andykarpov/karabas-mini-pcb/shield/v2/karabas-mini-shield.stl

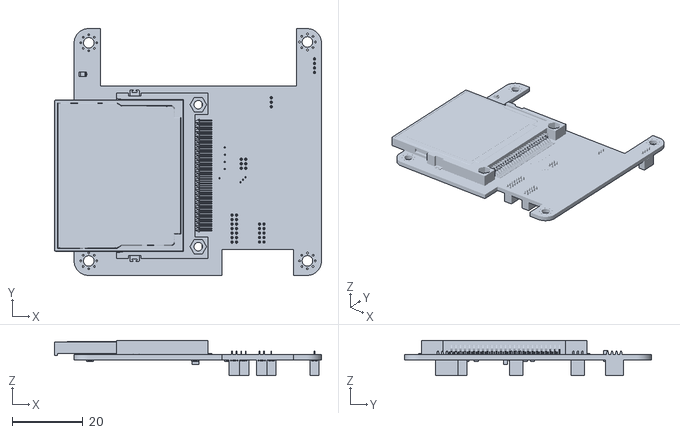
[picture p1: CAD file, 2026-05-14, an earlier design]
shield/v2/karabas-mini-shield.stl
75.5 x 69.8 x 10.00
