andykarpov/karabas-mini-pcb/Errata-revG2_rus.txt

Ошибки revG2:

1) Вывод 19 (~CS) SDRAM U11 разведён на вывод T3 FPGA U7 (цепь ~{SDR_CS}). На предыдущих ревизиях T3 - это
~{CONF_CS}, а ~CS SDRAM на FPGA не заведён, поэтому ядра считают T3 выбором flash и держат его в единице
(FLASH_CS_N = 1): SDRAM никогда не выбирается, и все ядра, которые её используют, не работают. T3 как ~CS
SDRAM управляет только karabas-go-core-sdram-test.

Подтяжки на цепи нет, дорожка идёт только по верхнему слою, без переходных отверстий.

Найдено по схеме и файлам платы. Подтверждено на плате revG2: резистор 1k от вывода 19 U11 на GND
исправил SDRAM (issue #2, фото: https://github.com/andykarpov/karabas-go/blob/master/docs/mini/revG2_mod.md).

Хотфикс: перерезать дорожку ~{SDR_CS} рядом с выводом 19 U11 и подключить вывод 19 к GND через резистор
1к..10к или перемычкой. Одного резистора на землю без реза недостаточно: выход FPGA удержит единицу.

Программное исправление (нужна пересборка каждого ядра): выводить 0 на T3 в топах Mini G (FLASH_CS_N = 0).
Это безопасно и на revG: посадочное место конфигурационной flash не запаивается, и ядра её не используют.
Вместе с хотфиксом не требуется.

В следующей ревизии: подключить вывод 19 U11 к GND.
