andykarpov/karabas-mini-pcb/karabas-mini-revG2.pdf

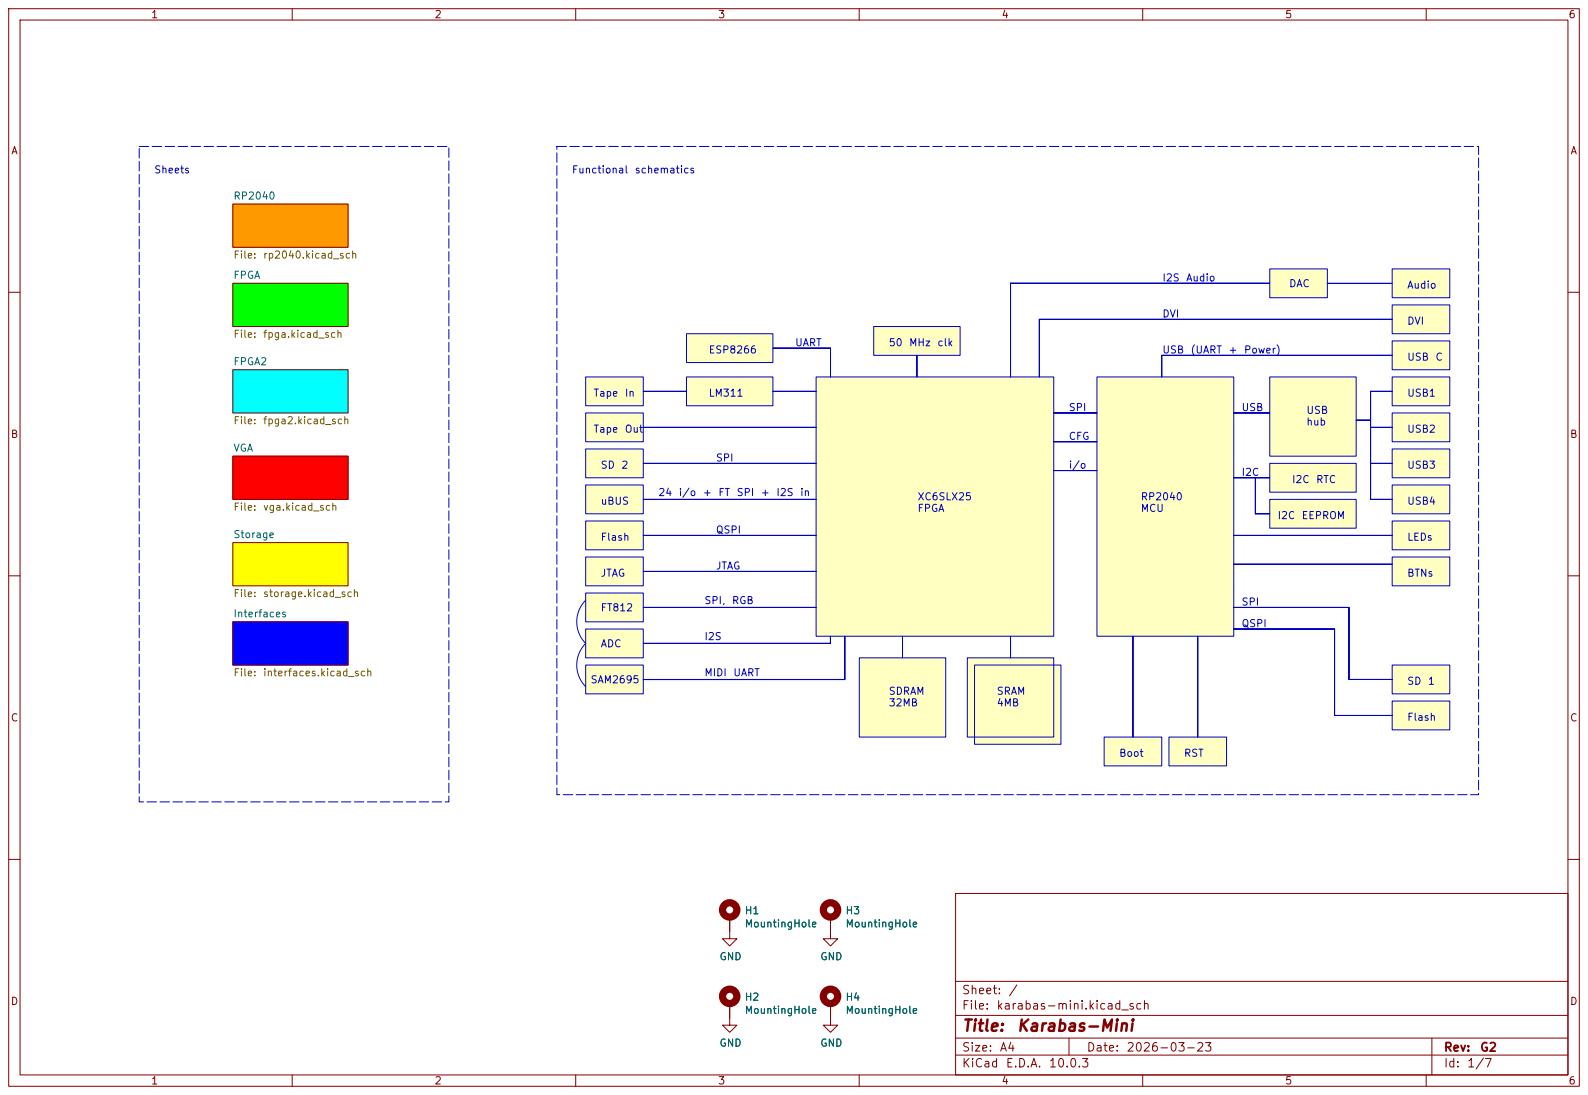
[picture p2: page 1]

Functional schematics 24 i/o + FT SPI + I2S in

Size: A4 | Rev: G2
KiCad E.D.A. 10.0.3 | Id: 1/7

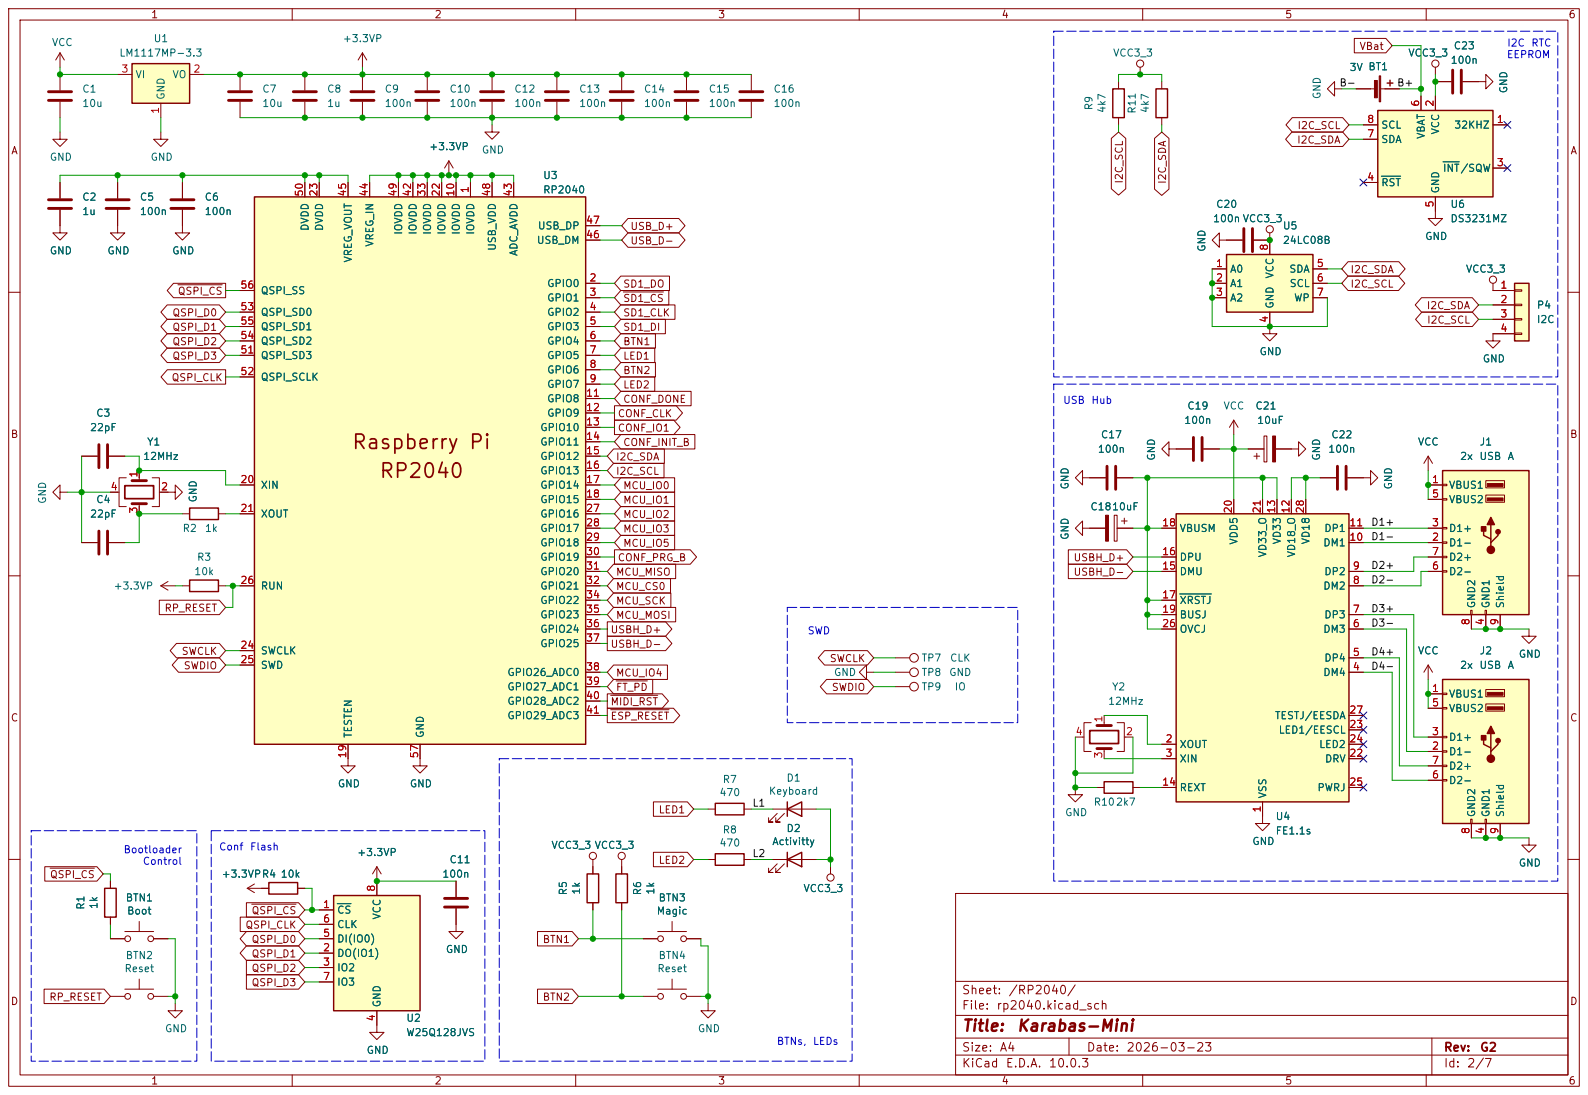
[picture p3: page 2]

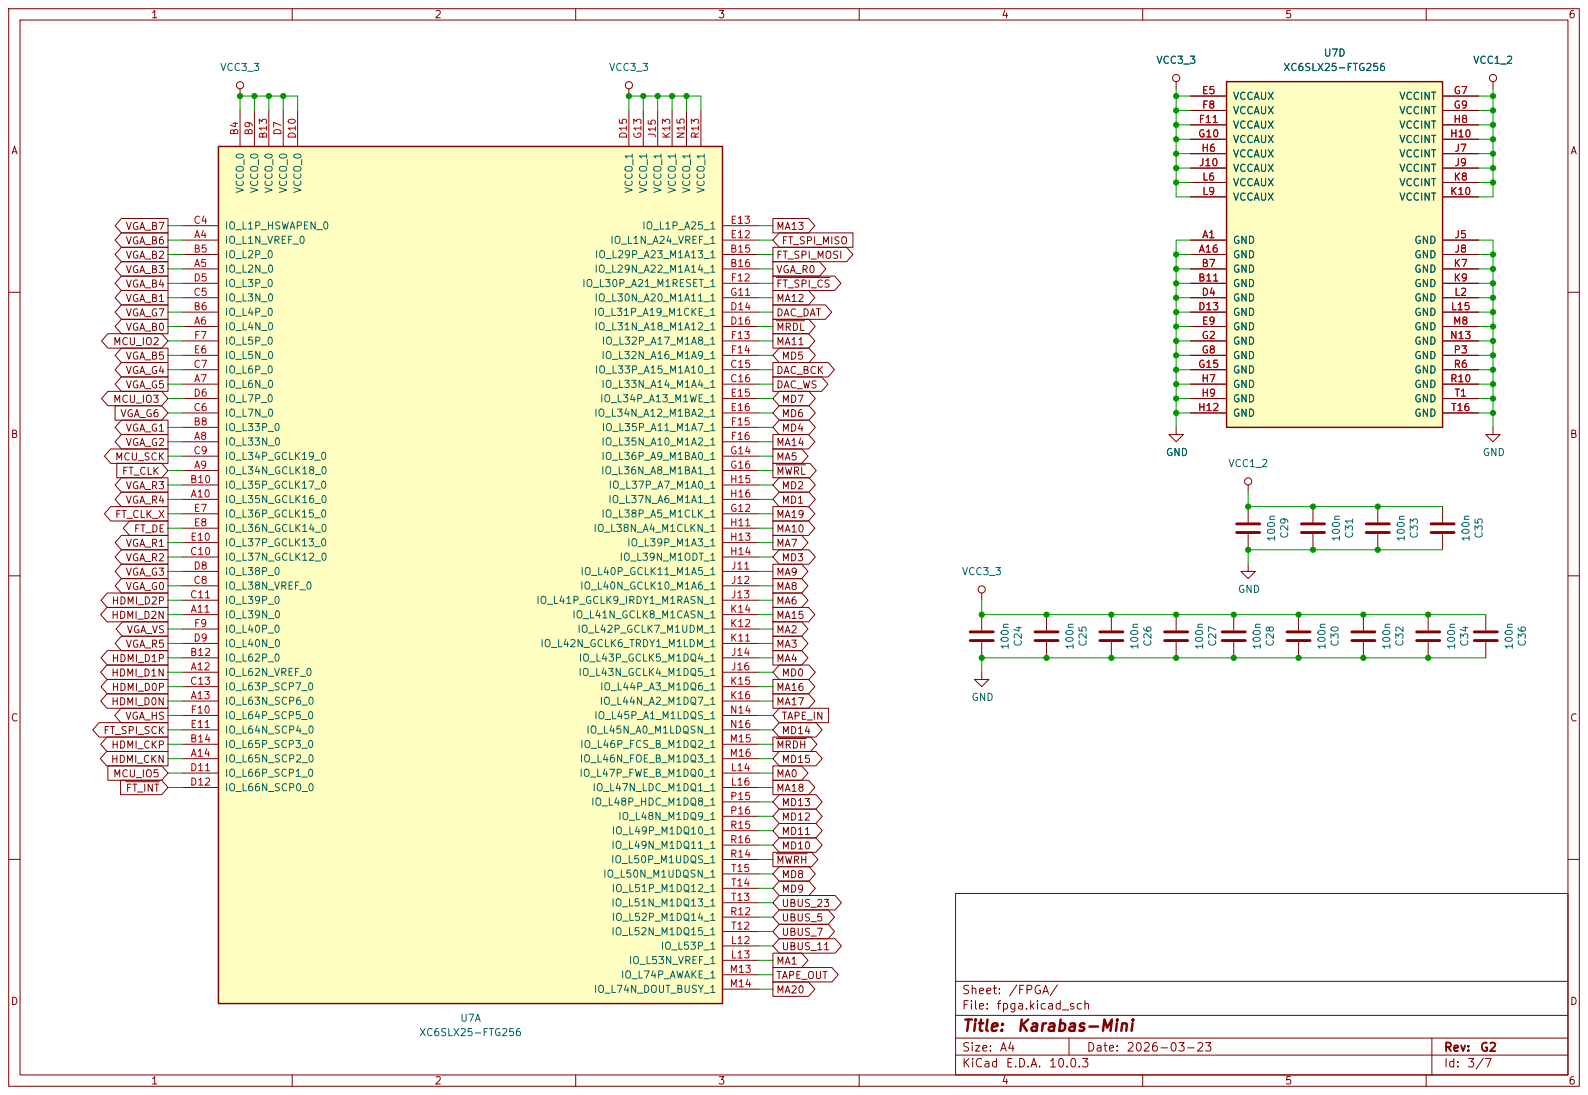
[picture p4: page 3]

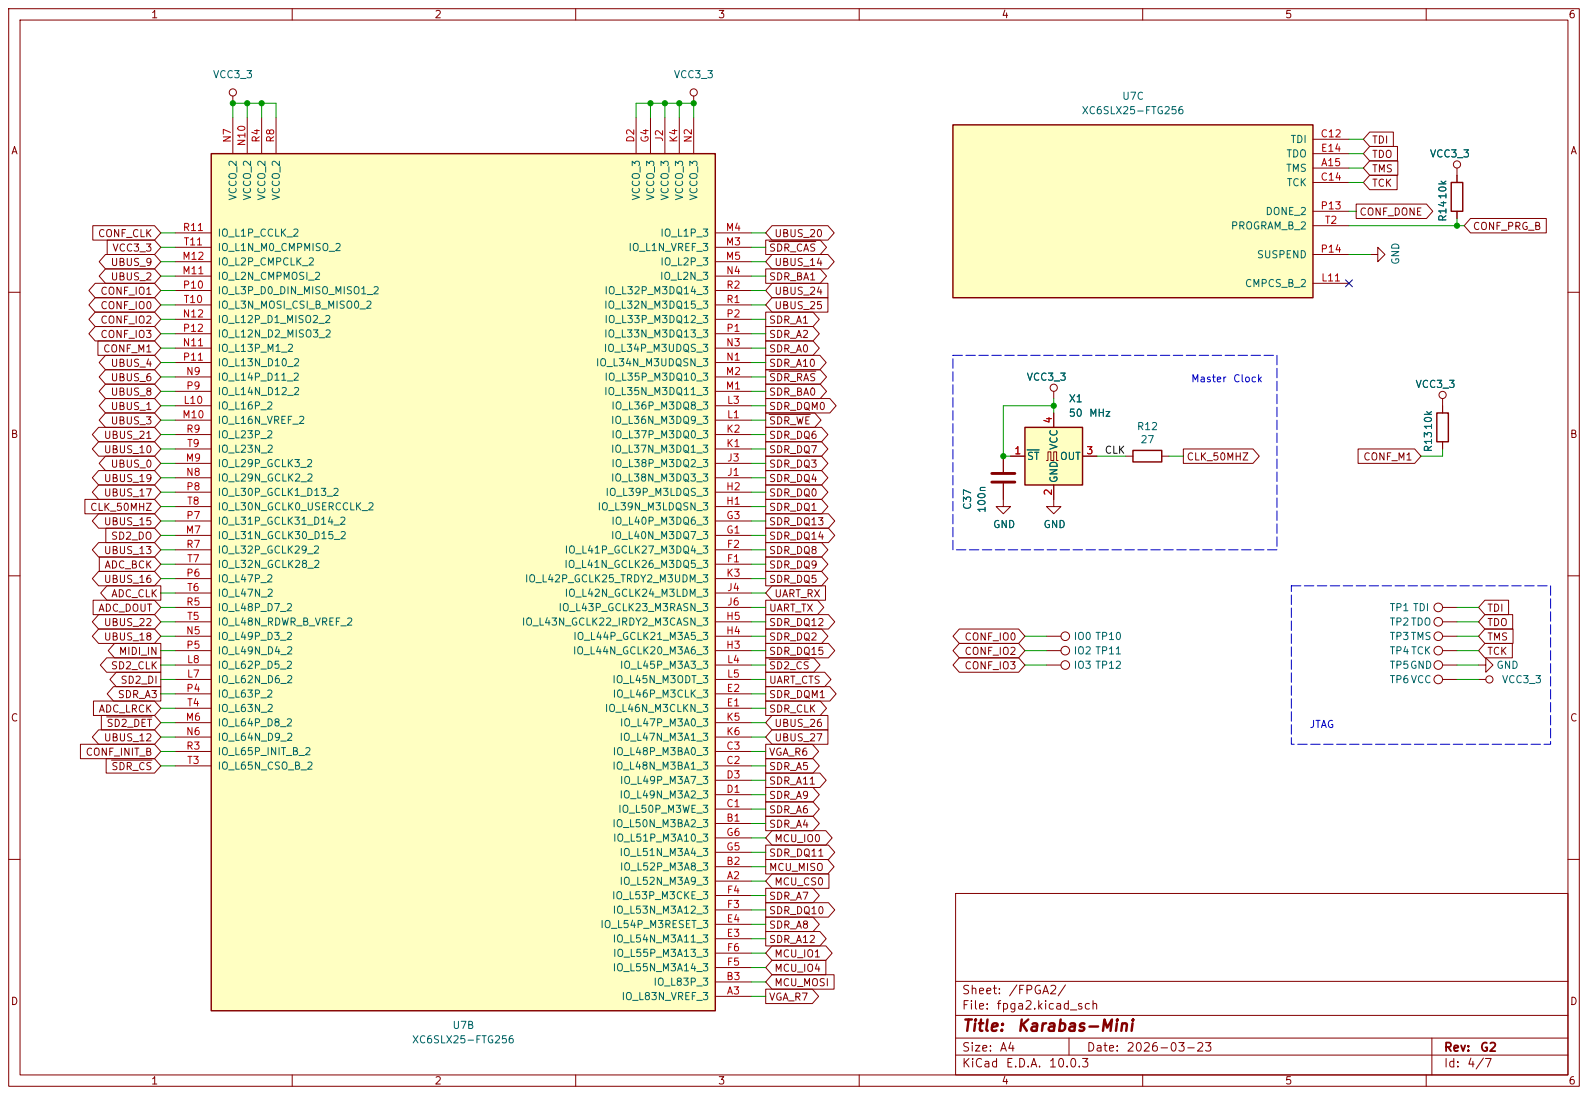
[picture p5: page 4]

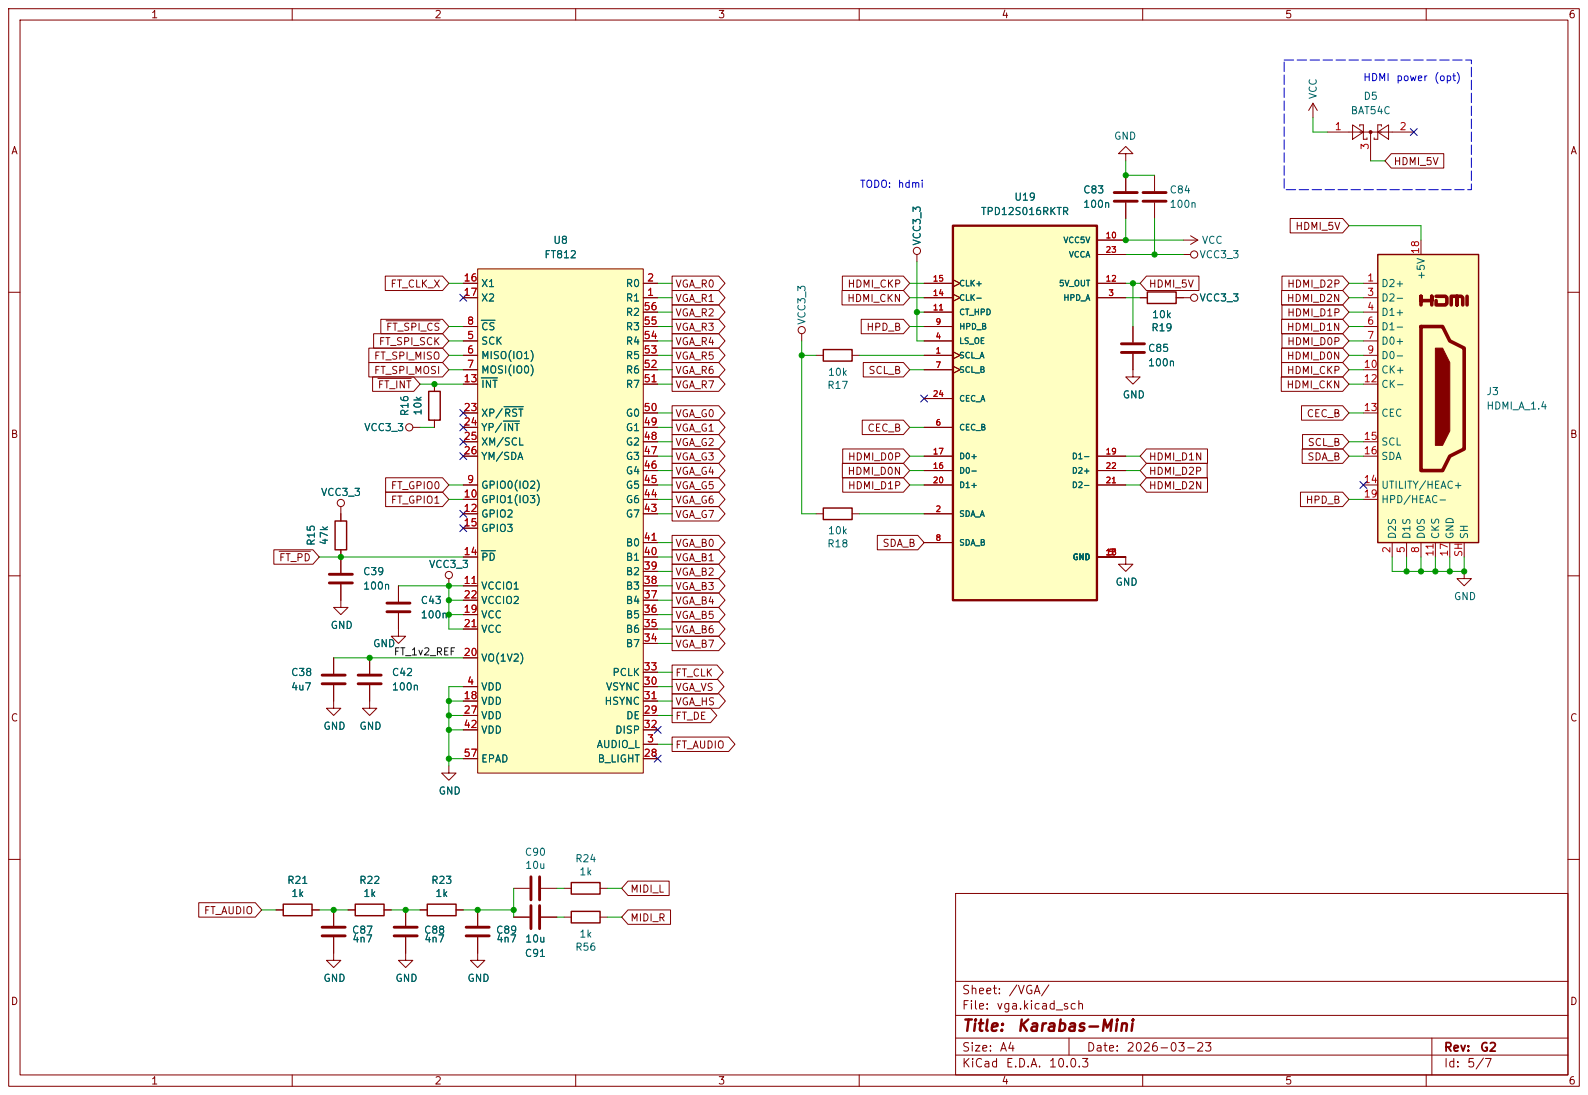
[picture p6: page 5]

XP/RST 23
YP/INT 24
XM/SCL 25
YM/SDA 26
VSYNC 30 HSYNC 31 DISP 32 PCLK 33 B7 34 B6 35 B5 36 B4 37 B3 38 B2 39 B1 40 B0 41

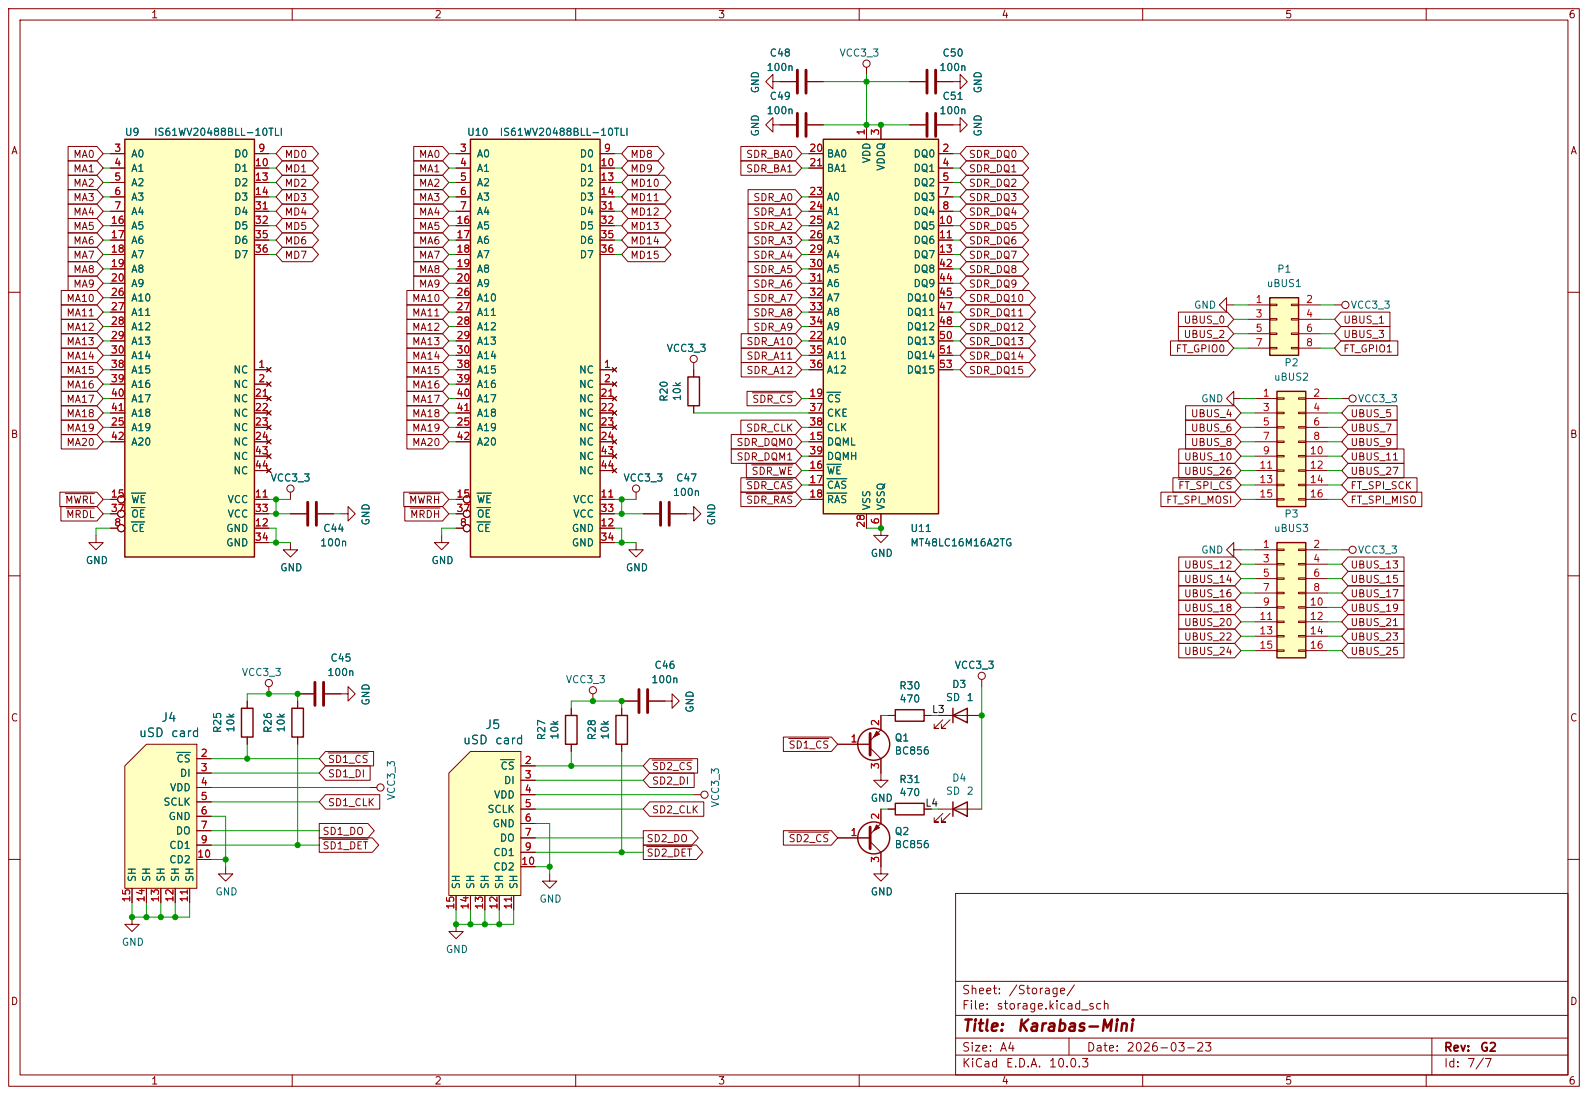
[picture p7: page 6]

6 DQ3 7 DQ4 8 DQ5 10 DQ6 11 DQ7 13 DQML 15 WE 16 CAS 17 RAS 18 CS 19 BA0 20 BA1 21

SCLK 5 GND 6 DO 7 CD1 9 CD2 10 SH 11 SH 12 SH 13 SH 14 SH 15

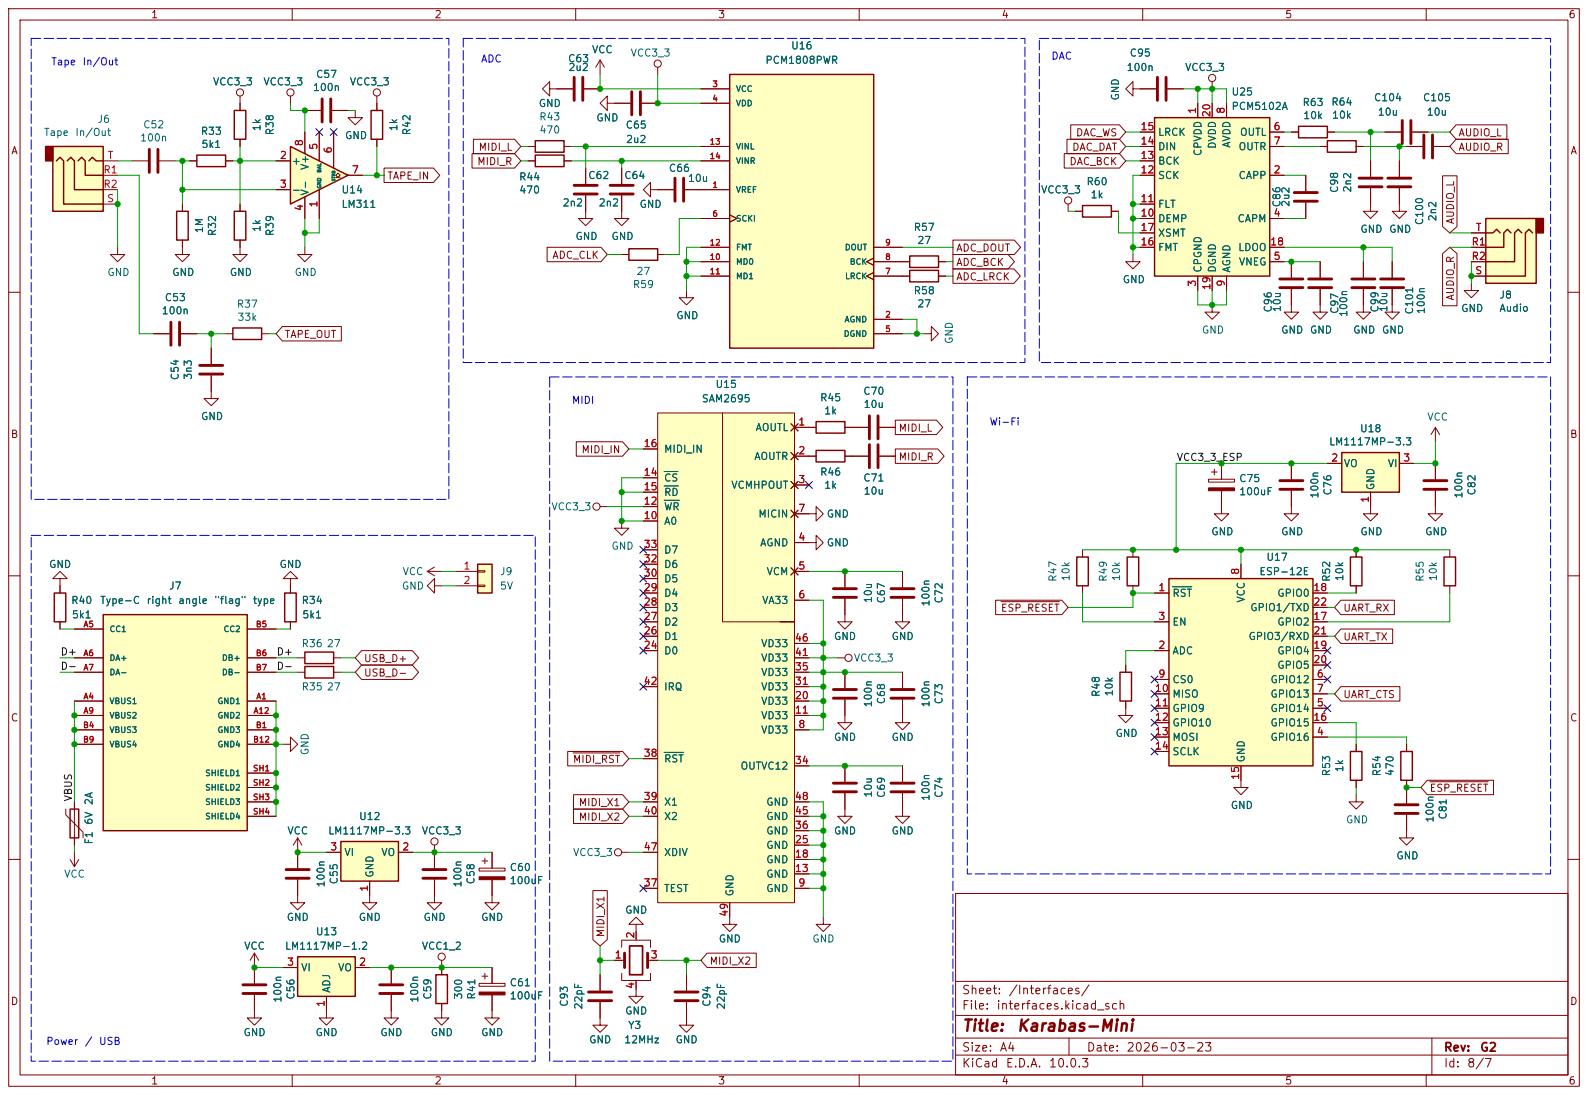
[picture p8: page 7]

10u C98 2n2 GND
SCK 12 BCK 13 DIN 14 LRCK 15

Type-C right angle "flag" type 100n C56 R35 27 R34
Type-C right angle "flag" type
