andykarpov/karabas-mini-pcb/karabas-mini-revC.pdf

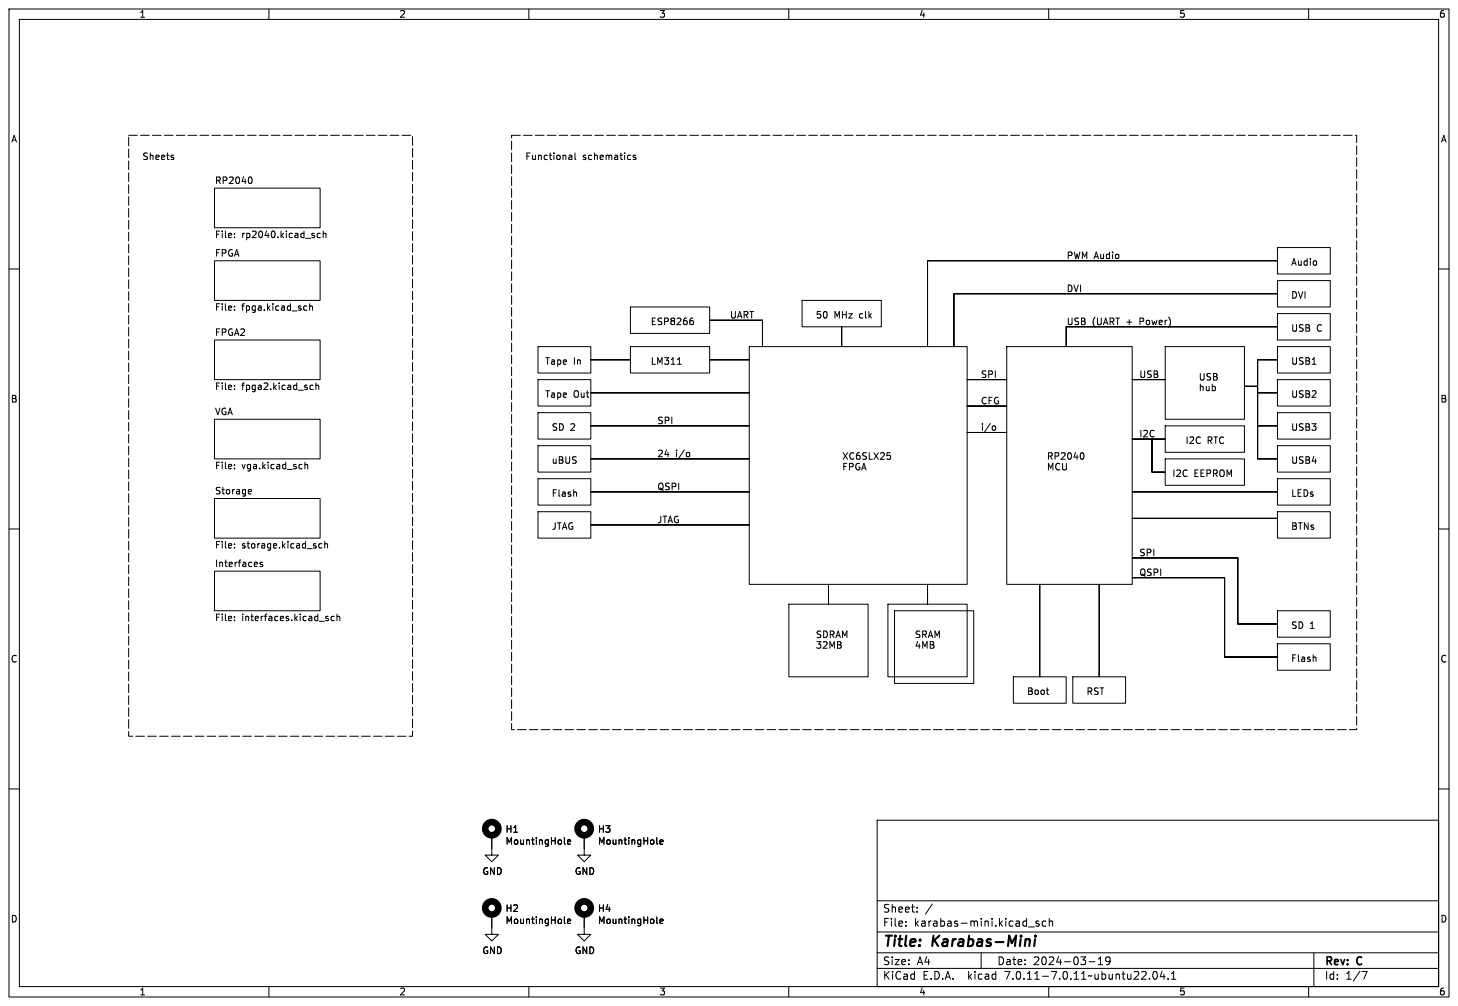
[picture p23: page 1]

File: fpga.kicad_sch RP2040 File: rp2040.kicad_sch VGA
Interfaces File: interfaces.kicad_sch FPGA

Id: 1/7 Title: Karabas-Mini File: karabas-mini.kicad_sch Sheet: /

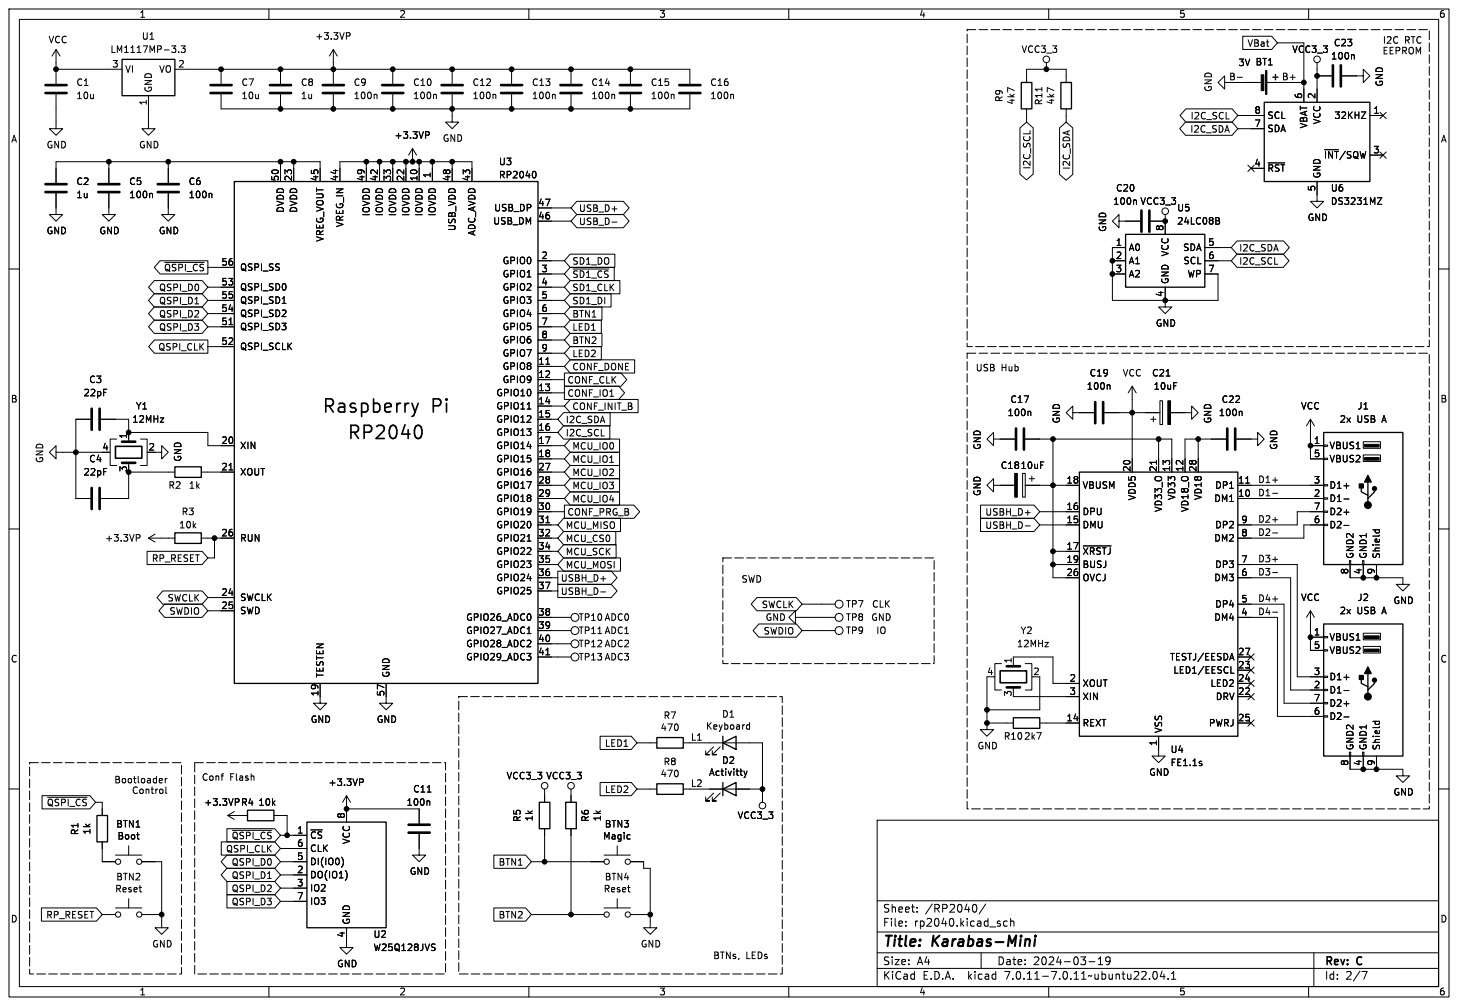
[picture p24: page 2]

6 SDA 7 SCL 8 U6 DS3231MZ GND GND GND GND

6 SDA 7 SCL 8 GND GND

1 IOVDD 10 GPIO8 11 GPIO9 12 GPIO10 13 GPIO11 14 GPIO12 15 GPIO13 16 GPIO14 17 GPIO15 18 TESTEN 19 GPIO0 2 XIN 20 XOUT 21 IOVDD 22 DVDD 23 SWCLK 24 SWD 25 RUN 26 GPIO16 27 GPIO17 28 GPIO18 29 GPIO1 3 GPIO19 30 GPIO20 31 GPIO21 32 IOVDD 33 GPIO22 34 GPIO23 35 GPIO24 36 GPIO25 37 GPIO26_ADC0 38 GPIO27_ADC1 39 GPIO2 4 GPIO28_ADC2 40 GPIO29_ADC3 41 IOVDD 42 ADC_AVDD 43 VREG_IN 44 VREG_VOUT 45 USB_DM 46 USB_DP 47 USB_VDD 48 IOVDD 49 GPIO3 5 DVDD 50 QSPI_SD3 51 QSPI_SCLK 52 QSPI_SD0 53 QSPI_SD2 54 QSPI_SD1 55 QSPI_SS 56 GND 57 GPIO4 6 GPIO5 7 GPIO6 8 GPIO7 9 U3 RP2040 TP10 ADC0 GND
VCC3_3 GND

1 IOVDD 10 GPIO8 11 GPIO9 12 GPIO10 13 GPIO11 14 GPIO12 15 GPIO13 16 GPIO14 17 GPIO15 18 TESTEN 19 GPIO0 2 XIN 20 XOUT 21 IOVDD 22 DVDD 23 SWCLK 24 SWD 25 RUN 26 GPIO16 27 GPIO17 28 GPIO18 29 GPIO1 3 GPIO19 30 GPIO20 31 GPIO21 32 IOVDD 33 GPIO22 34 GPIO23 35 GPIO24 36 GPIO25 37 GPIO26_ADC0 38 GPIO27_ADC1 39 GPIO2 4 GPIO28_ADC2 40 GPIO29_ADC3 41 IOVDD 42 ADC_AVDD 43 VREG_IN 44 VREG_VOUT 45 USB_DM 46 USB_DP 47 USB_VDD 48 IOVDD 49 GPIO3 5 DVDD 50 QSPI_SD3 51 QSPI_SCLK 52 QSPI_SD0 53 QSPI_SD2 54 QSPI_SD1 55 QSPI_SS 56 GND 57 GPIO4 6 GPIO5 7 GPIO6 8 GPIO7 9 GND

4 SDA 5 SCL 6 WP 7 VCC

1 DM1 10 DP1 11 VD18_O 12 VD33 13 REXT 14 DMU 15 DPU 16 ~{XRSTJ} 17 VBUSM 18 BUSJ 19 XOUT 2 VDD5 20 VD33_O 21 DRV 22

Id: 2/7 Title: Karabas-Mini File: rp2040.kicad_sch Sheet: /RP2040/

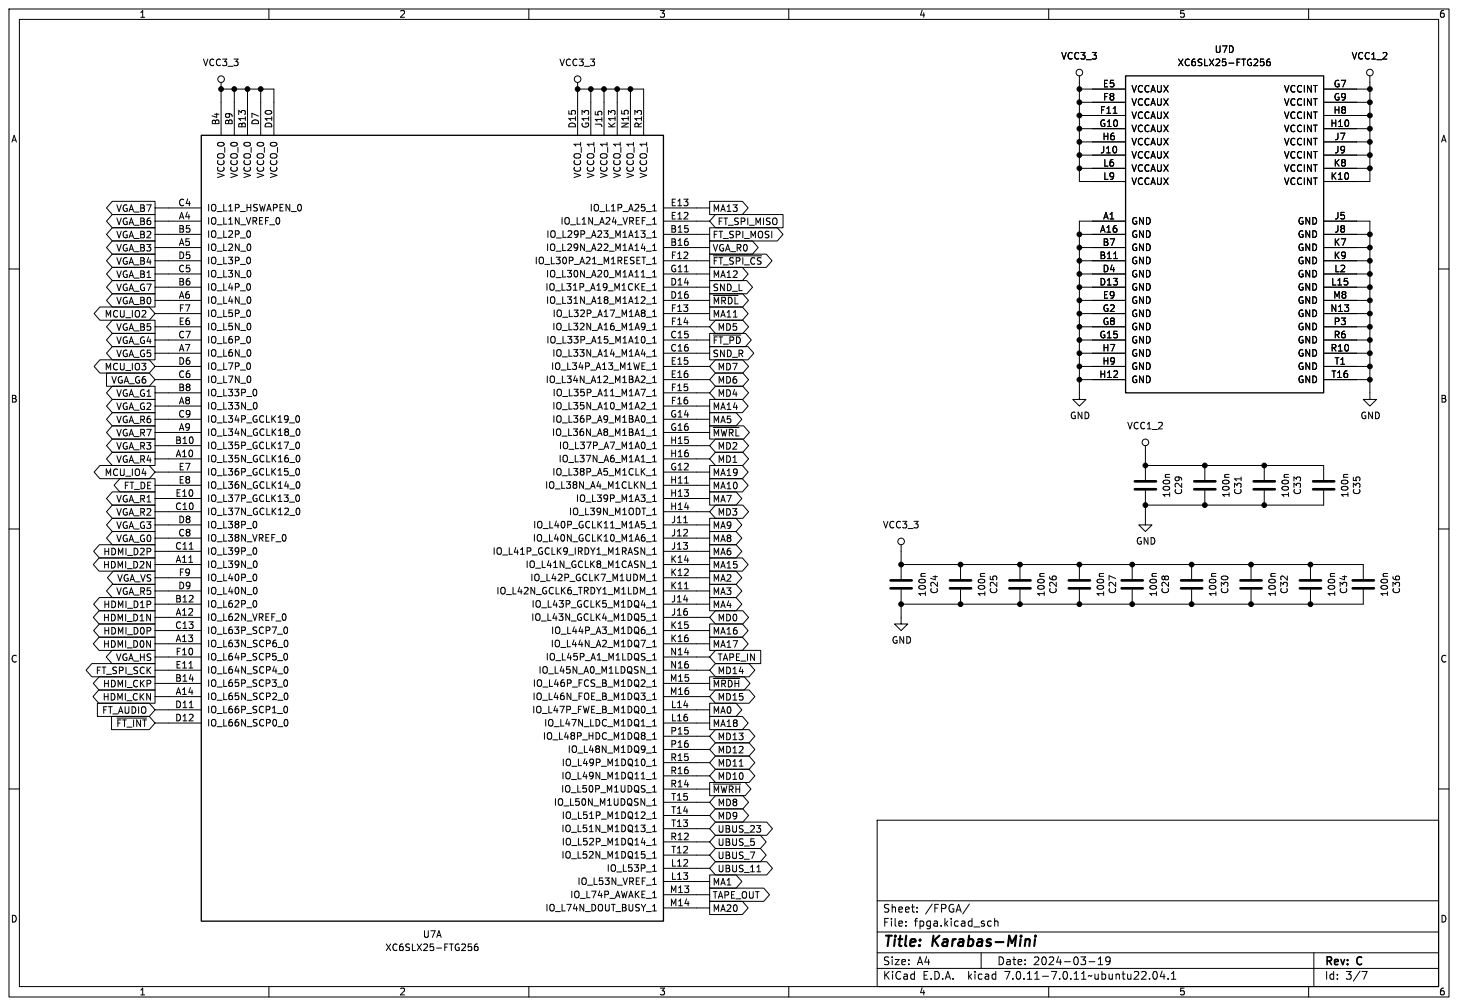
[picture p25: page 3]

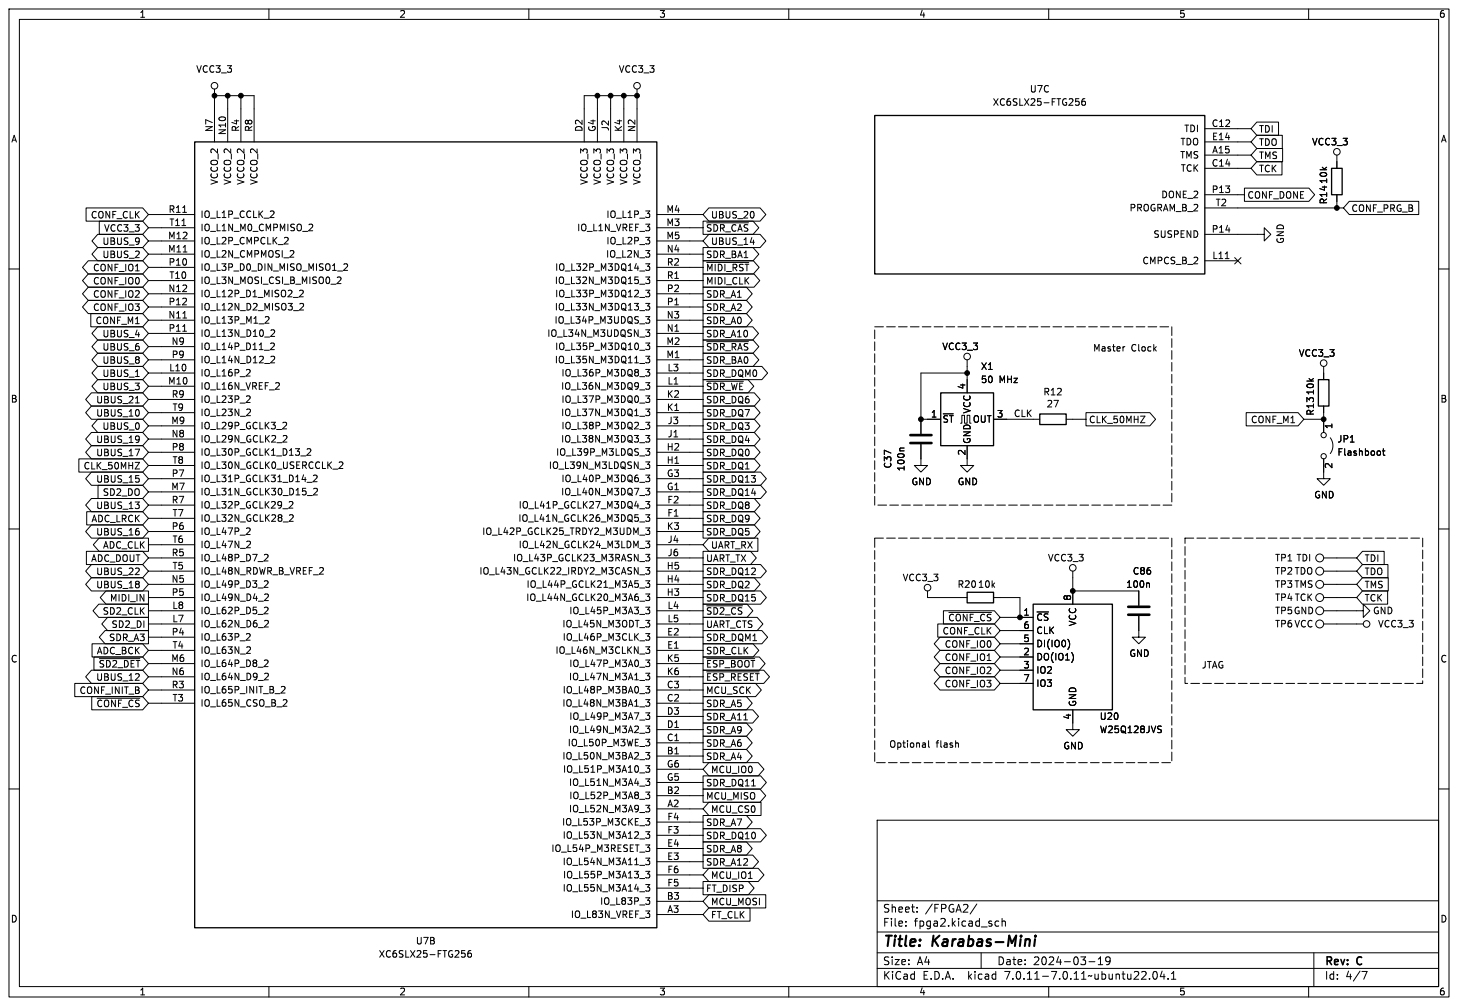
[picture p26: page 4]

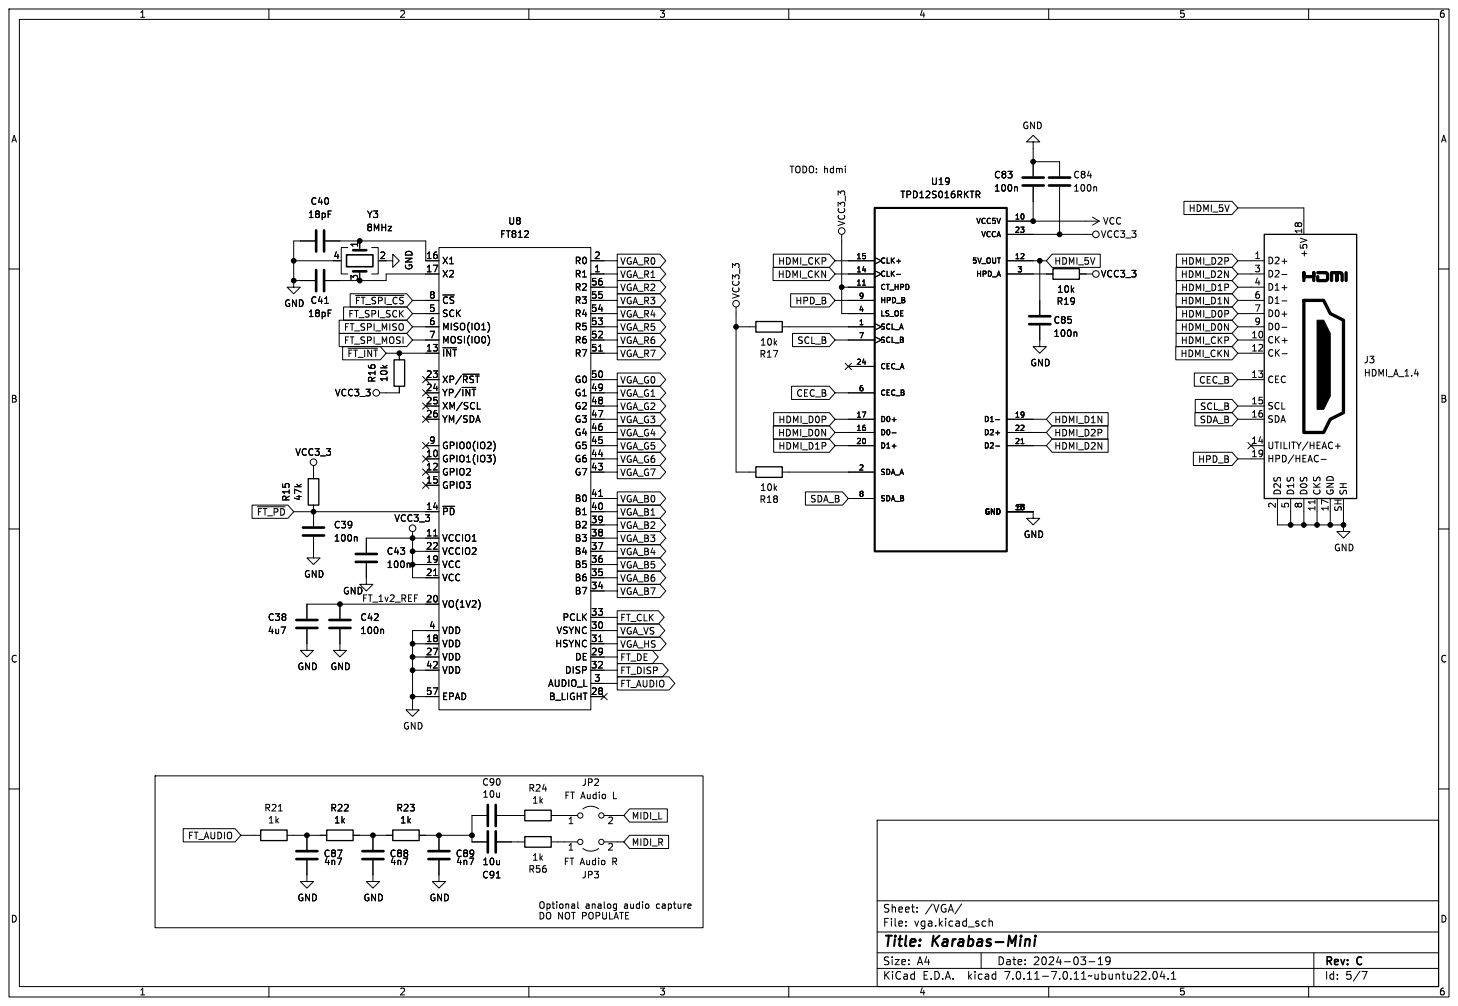
[picture p27: page 5]

Id: 5/7 Title: Karabas-Mini File: vga.kicad_sch Sheet: /VGA/

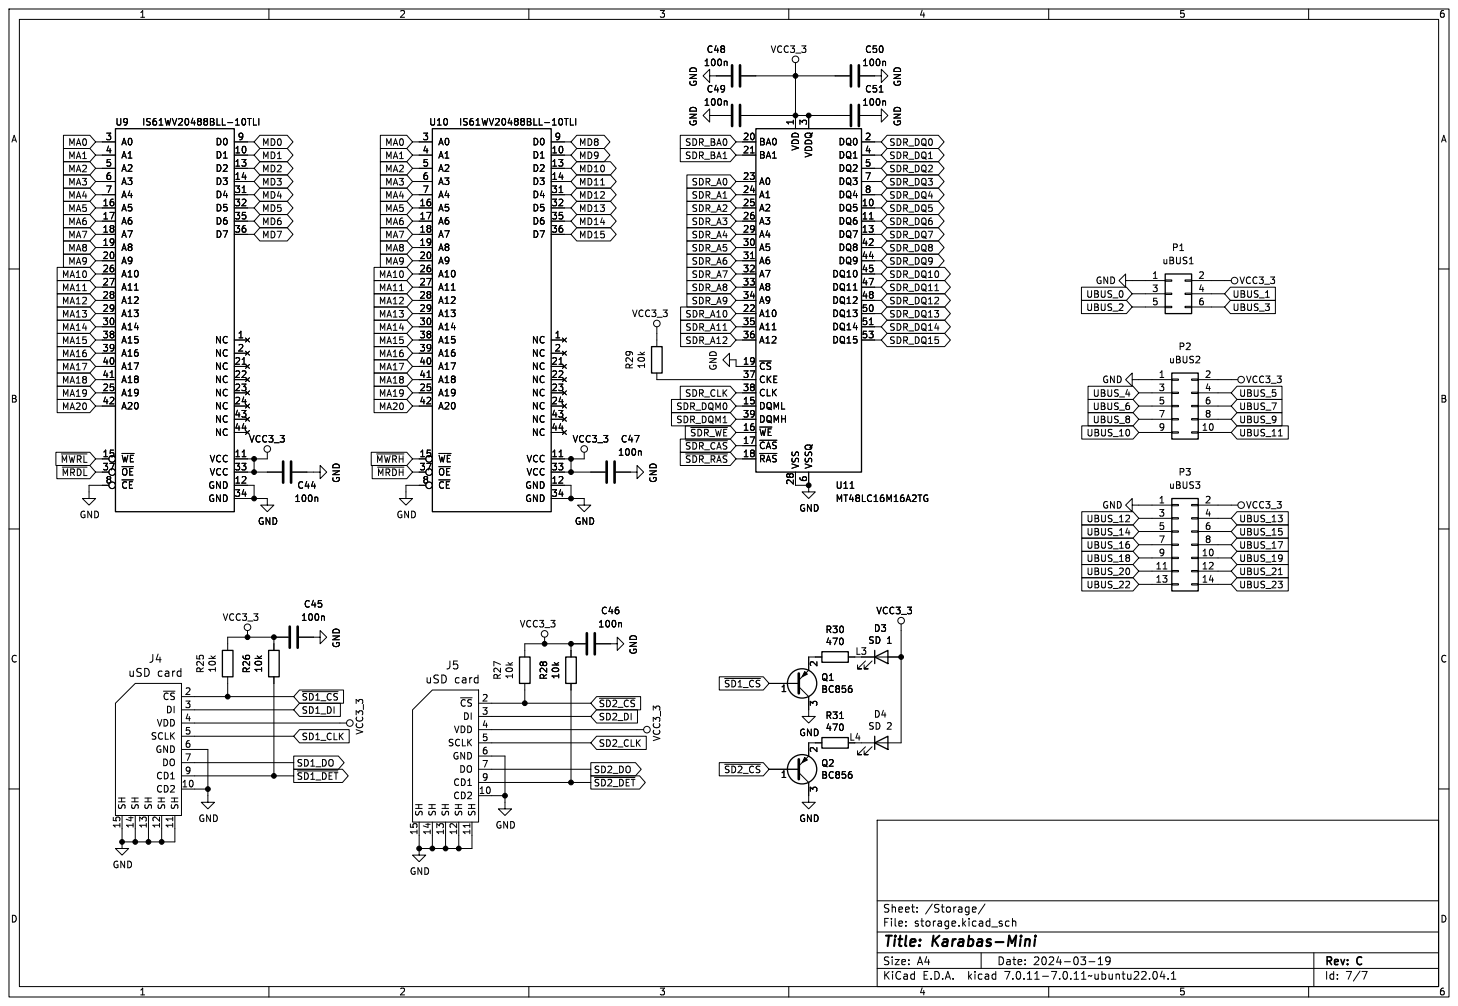
[picture p28: page 6]

1 DQ5 10 DQ6 11 DQ7 13 DQML 15 ~{WE} 16 ~{CAS} 17 ~{RAS} 18 ~{CS} 19 DQ0 2 BA0 20 BA1 21 A10 22 A0 23 A1 24 A2 25 A3 26 VSS 28 A4 29 VDDQ

3 A5 30 A6 31 A7 32 A8 33 A9 34 A11 35 A12 36 CKE 37 CLK 38 DQMH 39 DQ1 4 DQ8 42 DQ9 44 DQ10 45 DQ11 47 DQ12 48 DQ2 5 DQ13 50 DQ14 51 DQ15 53 VSSQ

VCC3_3 R25 10k VCC3_3
~{CS}2 DI 3 VDD 4 SCLK 5 GND 6 DO 7 CD1 9 J4

~{CS}2 DI 3 VDD 4 SCLK 5 GND 6 DO 7 CD1 9 J5

Id: 7/7 Title: Karabas-Mini File: storage.kicad_sch Sheet: /Storage/ CD2 10 SH 11 SH 12 SH 13 SH 14 SH 15

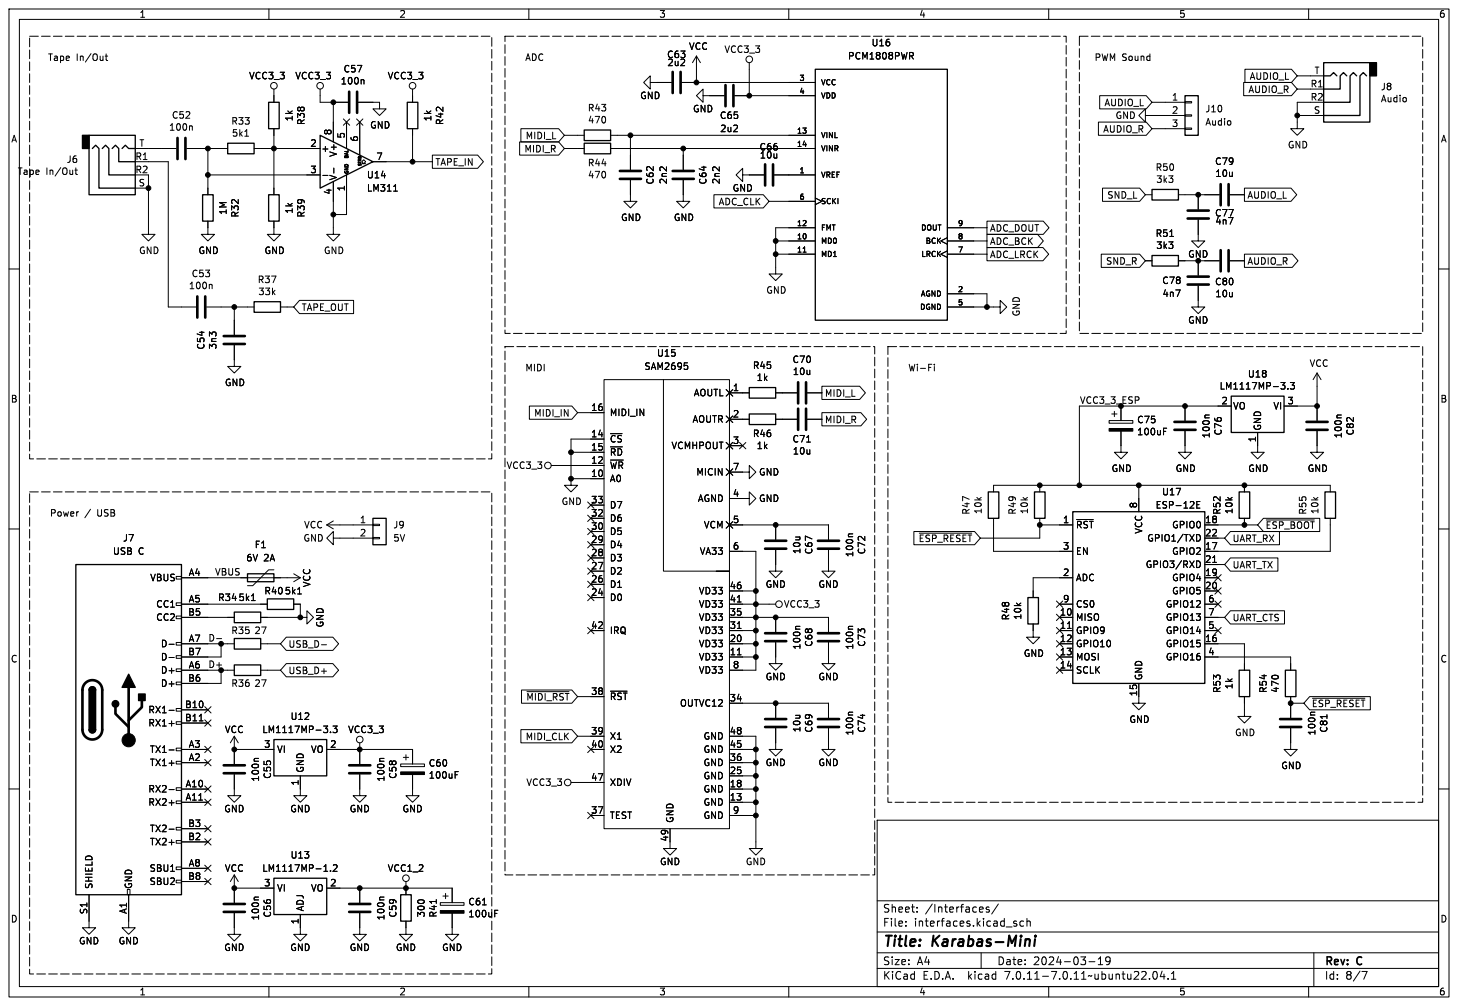
[picture p29: page 7]

8 CS0 9 U17 ESP-12E GND R55 10k GND C73 100n C81 100n C76 100n GND
