andykarpov/karabas-mini-pcb/(commit log)

2024-02-20 Updated revA: replaced resistors with IC for HDMI protection
    [fpga.kicad_sch, fpga2.kicad_sch, interfaces.kicad_sch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]
2024-02-22 Cleanup revA
    [fpga.kicad_sch, fpga2.kicad_sch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]
2024-02-23 Updated revB
    [fpga.kicad_sch, fpga2.kicad_sch, interfaces.kicad_sch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]
2024-02-23 Updated gerbers
2024-03-19 Fixed HDMI diff-pairs pinout, rev.C
    [fpga.kicad_sch, fpga2.kicad_sch, interfaces.kicad_sch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]
2024-04-15 Small improvements revC
    [interfaces.kicad_sch, karabas-mini.kicad_pcb]
2024-04-17 PCB revD
    [fpga.kicad_sch, fpga2.kicad_sch, interfaces.kicad_sch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]
2024-05-26 Compressed revF gerbers
2024-06-05 latest changed F1
    [karabas-mini.kicad_pcb]
2024-06-05 F1 gerbers
    [karabas-mini-B_Cu.gbr, karabas-mini-B_Mask.gbr, karabas-mini-B_Paste.gbr, karabas-mini-B_Silkscreen.gbr, karabas-mini-Edge_Cuts.gbr, karabas-mini-F_Cu.gbr, karabas-mini-F_Mask.gbr, karabas-mini-F_Paste.gbr]
2026-05-14 rev.G2 WIP
    [fpga.kicad_sch, fpga2.kicad_sch, interfaces.kicad_sch, karabas-mini.kicad_pcb, karabas-mini.kicad_sch, rp2040.kicad_sch, storage.kicad_sch, vga.kicad_sch]
2026-05-14 Added shield PCB sources
    [karabas-mini-shield.kicad_pcb, karabas-mini-shield.kicad_sch, karabas-mini-shield.stl]
2026-06-11 Added shield v4 for revG with pass-thru i2c and 5v for the 3rd floor :)
    [karabas-mini-shield.kicad_pcb, karabas-mini-shield.kicad_sch]
2026-06-11 Shield v4
    [karabas-mini-shield.kicad_pcb]
2026-06-11 Dot matrix display shield for revG shield v4
    [karabas-mini-shield.kicad_pcb, karabas-mini-shield.kicad_sch]
2026-06-12 Added rounded corners to shield v4 pcb
    [karabas-mini-shield.kicad_pcb]
2026-11-12 Errata revG2: the SDRAM ~CS hotfix confirmed on a revG2 board (#2)
