andykarpov/karabas-mini-pcb/shield/v1/karabas-mini-shield.kicad_pcb

## KiCad design shield/v1/karabas-mini-shield.kicad_pcb (2026-05-14, an earlier design)

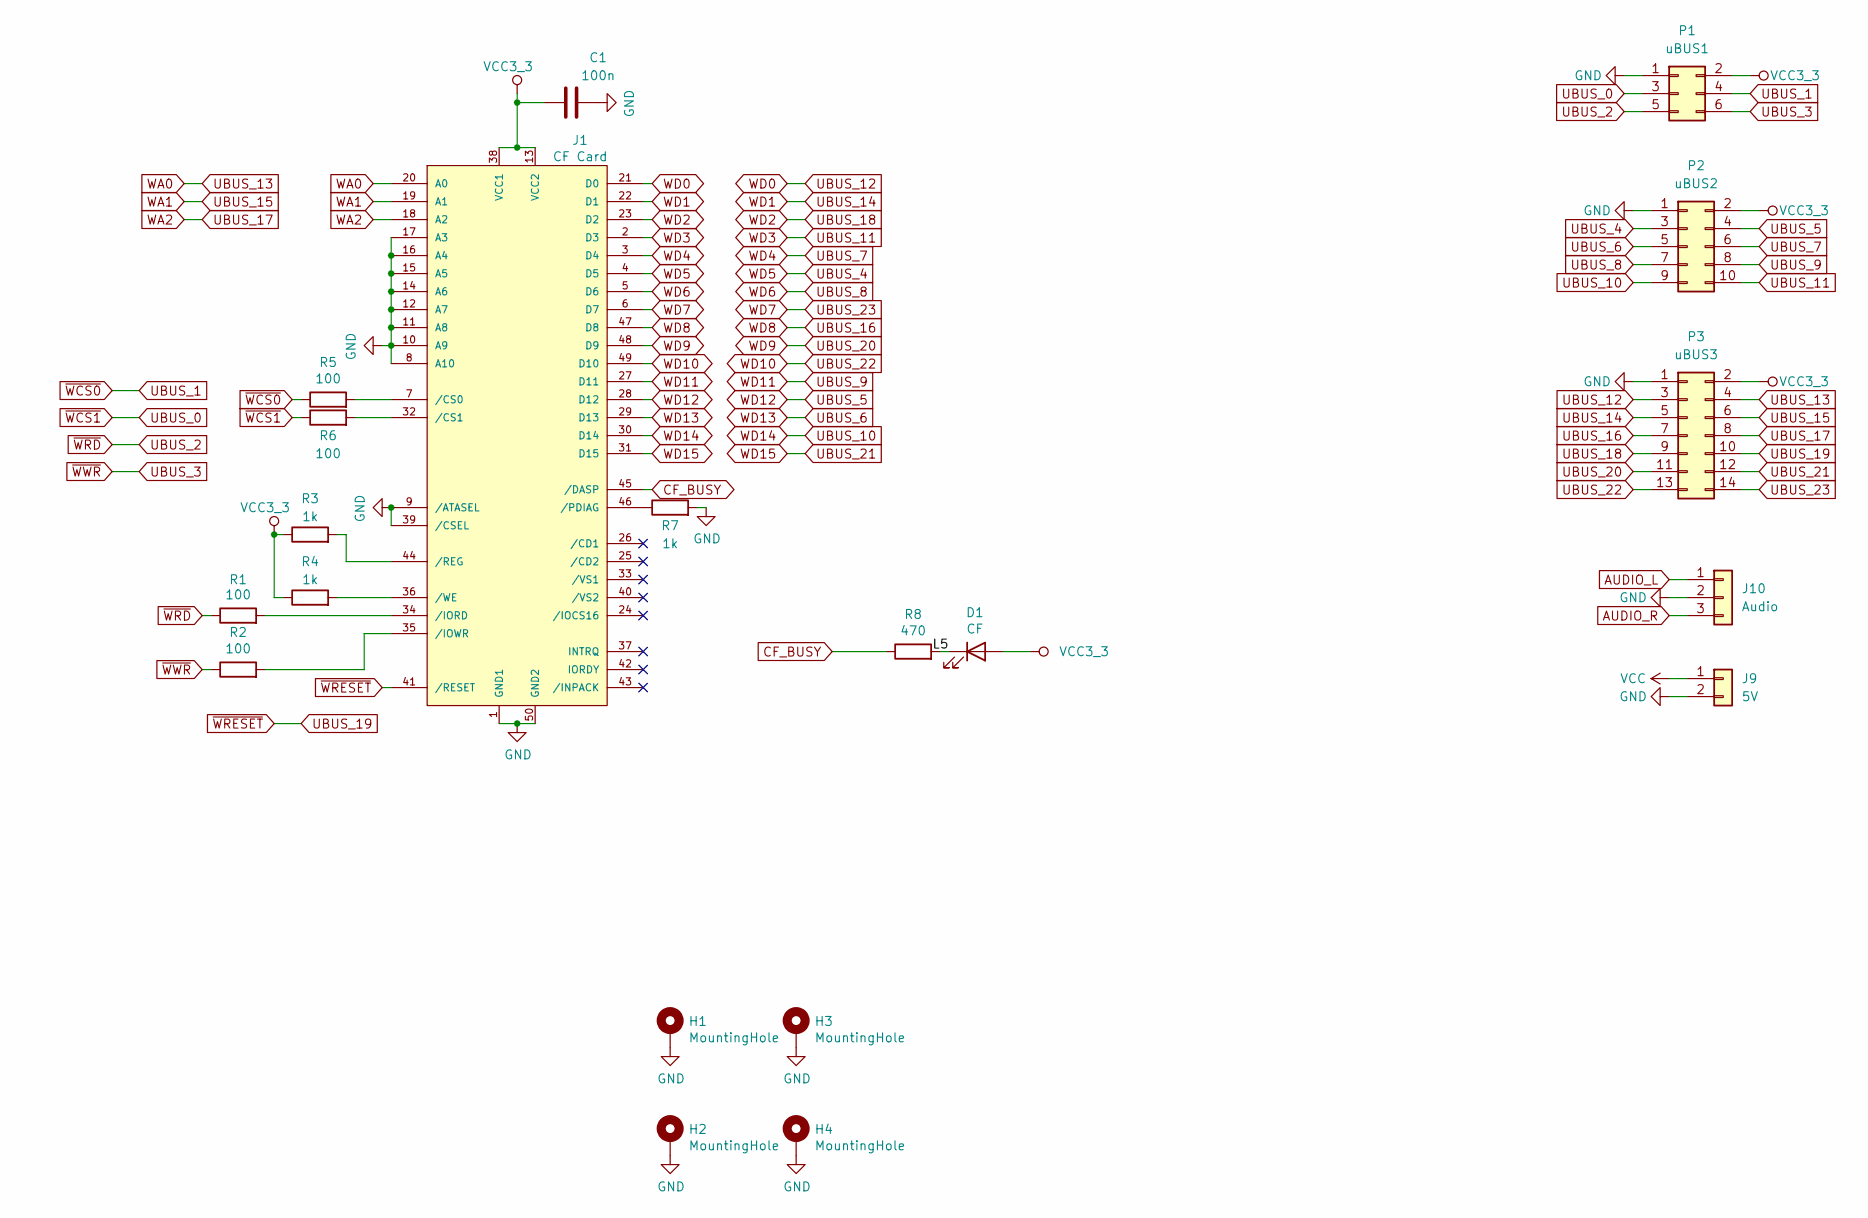
[picture p13: schematic karabas-mini-shield.kicad_sch, Karabas-Mini]

Parts:
C1: 100n; C_0805_2012Metric_Pad1.18x1.45mm_HandSolder
D1: CF; LED_0805_2012Metric_Pad1.15x1.40mm_HandSolder
H1, H2, H3, H4: MountingHole; MountingHole_3mm_Pad_Via
J1: CF Card; TE_1734451-1-LONG
J9: 5V; PinSocket_1x02_P1.27mm_Vertical
J10: Audio; PinSocket_1x03_P1.27mm_Vertical
P1: uBUS1; PinSocket_2x03_P1.27mm_Vertical
P2: uBUS2; PinSocket_2x05_P1.27mm_Vertical
P3: uBUS3; PinSocket_2x07_P1.27mm_Vertical
R1, R2, R5, R6: 100; R_0805_2012Metric_Pad1.20x1.40mm_HandSolder
R3, R4, R7: 1k; R_0805_2012Metric_Pad1.20x1.40mm_HandSolder
R8: 470; R_0805_2012Metric_Pad1.20x1.40mm_HandSolder

Connections:
/L5: D1.1 (K), R8.2
AUDIO_L: J10.1
AUDIO_R: J10.3
CF_BUSY: J1.45 (/DASP), R8.1
GND: C1.2, H1.1, H2.1, H3.1, H4.1, J1.1 (GND1), J1.8 (A10), J1.9 (/ATASEL), J1.10 (A9), J1.11 (A8), J1.12 (A7), J1.14 (A6), J1.15 (A5), J1.16 (A4), J1.17 (A3), J1.39 (/CSEL), J1.50 (GND2), J9.2, J10.2, P1.1, P2.1, P3.1, R7.2
unnamed: J1.7 (/CS0), R5.2
unnamed: J1.32 (/CS1), R6.2
unnamed: J1.34 (/IORD), R1.2
unnamed: J1.35 (/IOWR), R2.2
unnamed: J1.46 (/PDIAG), R7.1
unnamed: J1.44 (/REG), R3.2
unnamed: J1.36 (/WE), R4.2
UBUS_0: P1.3, R6.1
UBUS_1: P1.4, R5.1
UBUS_2: P1.5, R1.1
UBUS_3: P1.6, R2.1
UBUS_4: J1.4 (D5), P2.3
UBUS_5: J1.28 (D12), P2.4
UBUS_6: J1.29 (D13), P2.5
UBUS_7: J1.3 (D4), P2.6
UBUS_8: J1.5 (D6), P2.7
UBUS_9: J1.27 (D11), P2.8
UBUS_10: J1.30 (D14), P2.9
UBUS_11: J1.2 (D3), P2.10
UBUS_12: J1.21 (D0), P3.3
UBUS_13: J1.20 (A0), P3.4
UBUS_14: J1.22 (D1), P3.5
UBUS_15: J1.19 (A1), P3.6
UBUS_16: J1.47 (D8), P3.7
UBUS_17: J1.18 (A2), P3.8
UBUS_18: J1.23 (D2), P3.9
UBUS_19: J1.41 (/RESET), P3.10
UBUS_20: J1.48 (D9), P3.11
UBUS_21: J1.31 (D15), P3.12
UBUS_22: J1.49 (D10), P3.13
UBUS_23: J1.6 (D7), P3.14
VCC: J9.1
VCC3_3: C1.1, D1.2 (A), J1.13 (VCC2), J1.38 (VCC1), P1.2, P2.2, P3.2, R3.1, R4.1

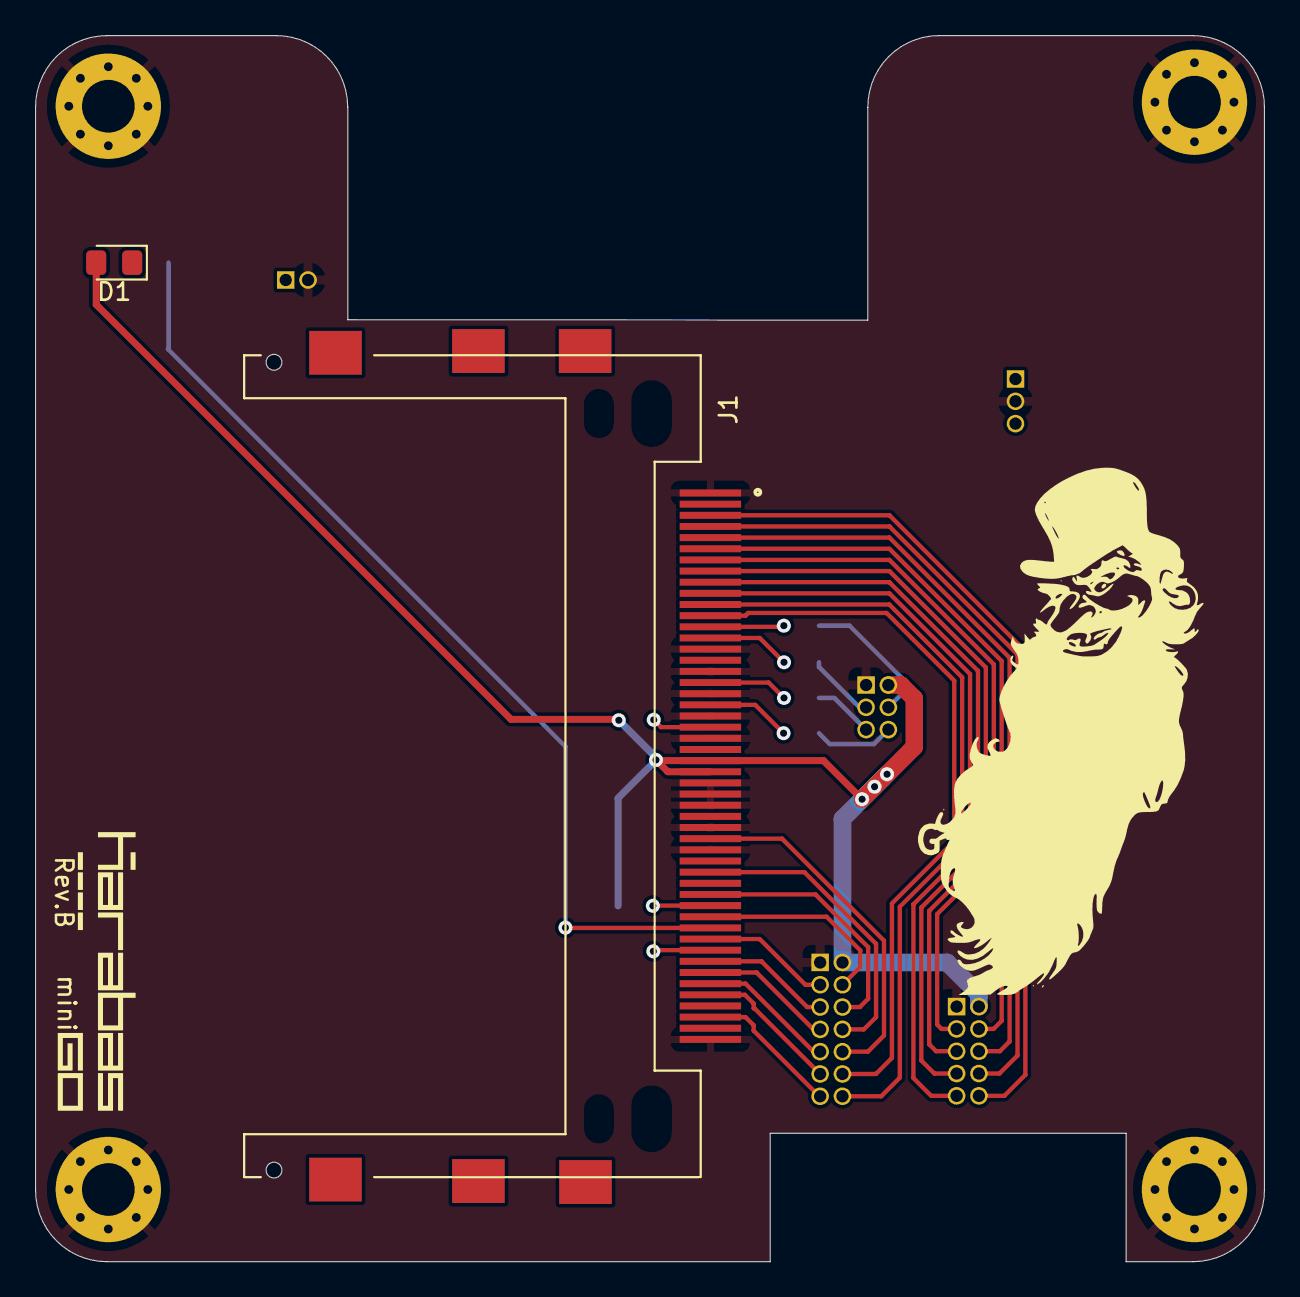
[picture p14: board shield/v1/karabas-mini-shield.kicad_pcb from above]

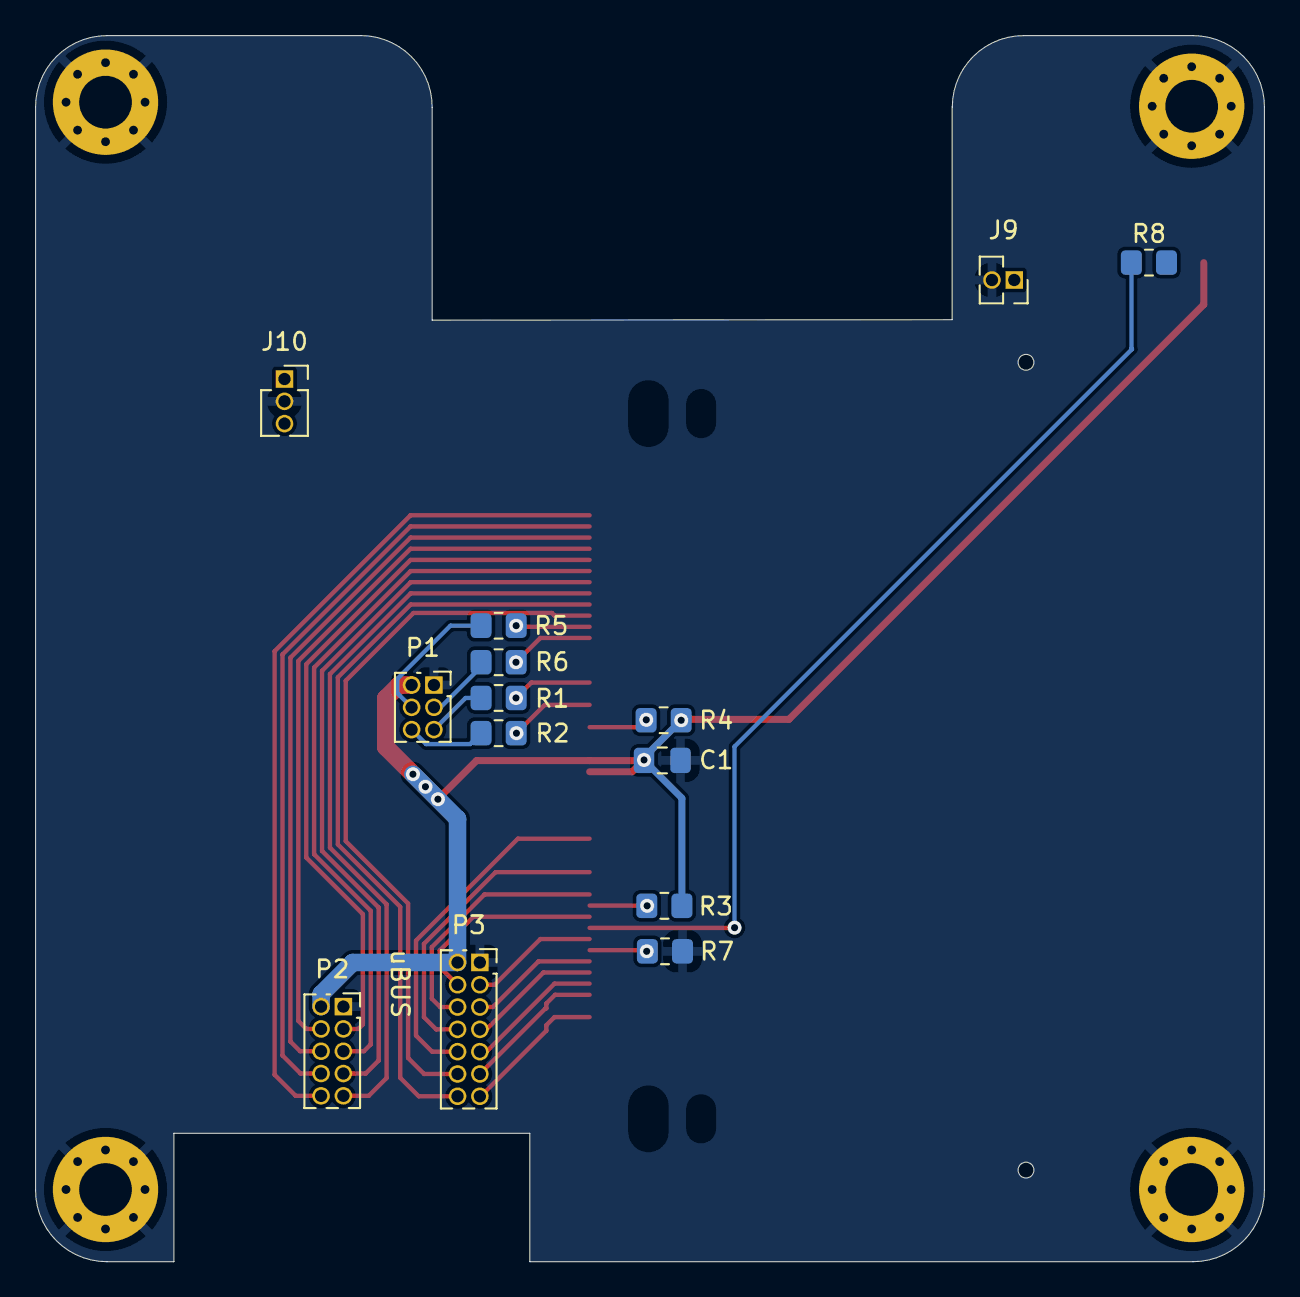
[picture p15: board shield/v1/karabas-mini-shield.kicad_pcb from below]

Board: 2 copper layers, 70.0 x 69.8 mm, 20 parts (14 on the bottom side), 35 nets.
