andykarpov/karabas-mini-pcb/(notices)

Notices in the files:
karabas-mini.kicad_pcb:
© 2026 andykarpov
